DrOnkel/Rehab/README.md

# Rehab
The Post Stroke Spasticity Rehab Helper
