DrOnkel/Rehab/ReHabMath.pdf

ReHab Helper - Program comments and math

5-bar linkage
We use 5-bar linkage for 2D- movement. Two servo (7,8) rotate two lever arms (1,2), coupled with secondary lever arms by screw and nuts. Other ends of secondary lever arms coupled by screw and nuts too. In test system pointer is linked to this joint. The system of lever arms can rotate in all joints. The pointer can reach any point in area between two semicircles with radius= L1+L2 with centers in the middle of servo shafts. We connect servos to Arduino controller and

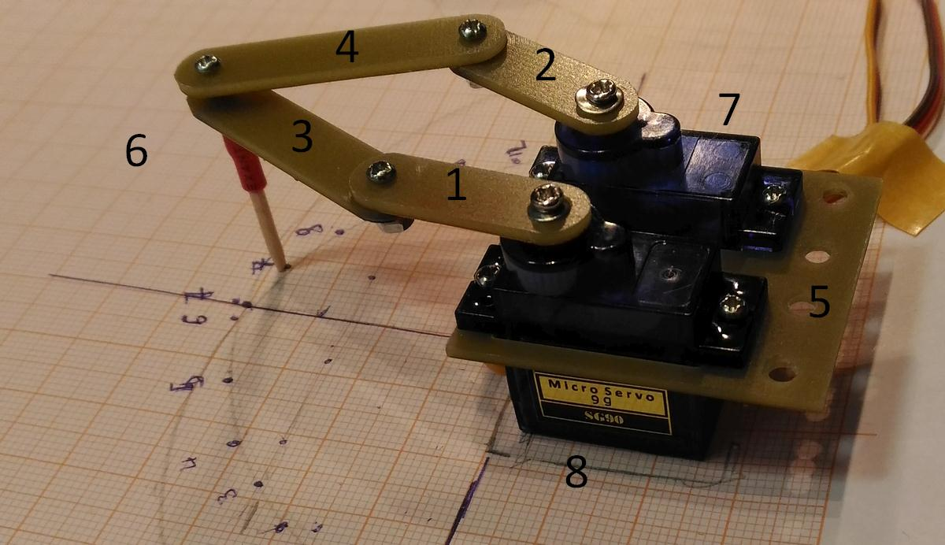
[picture p1: figure]

download ServoPot2Tester.ino program. We rotate potentiometers until the pointer is in the point we need. On monitor we can see the values of servo angles, we denote this angles as fi and psi.

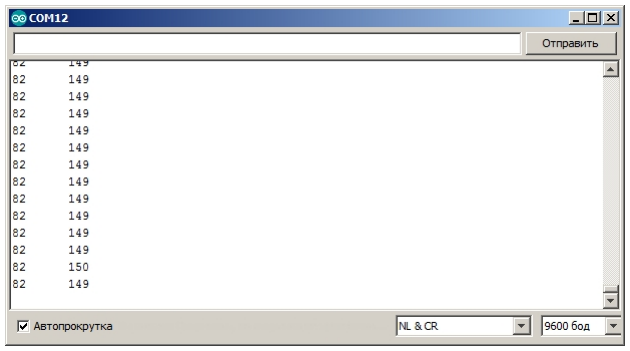
[picture p2: figure]

Write down the data for all 8 points of the path. You can insert the data in arrays of the program, in the array x (x=1,2,..7) Massx[8][2] in the order fi0, psi0, fi0, psi0 …. fi7, psi7 , and for the reverse array Massxr[8][2] in the order order fi7, psi7, fi6, psi6 …. Fi0, psi0 . You can insert data for any or all arrays instead of our default data. Modes 7 -16 are the same but with thumb movement. The Mode 17 is only thumb movement.

The program
Let us see the main parts of program. From the beginning.

You have to load LedControl library to you Arduino IDE program, please find it on http://playground.arduino.cc/Main/LedControl .

We use servo library from Arduino IDE program, the servo library is as a rule installed in core IDE.

Arduino controller calculate intermediate points within 8 points of the array. It makes the servo movement smooth and without jerks. The number of intermediate points can be from 3 to 35. The more the number the slowly moves the lever arms.

In the end of a program is a code for serial output of some data, it show the Mode , i and ns – number of point and of iteration within the points, Fi and Psi – angles of servo, Timer – time in milliseconds between the movements, Frames – quantity of iterations within the points, and Wipes- total wipes done.

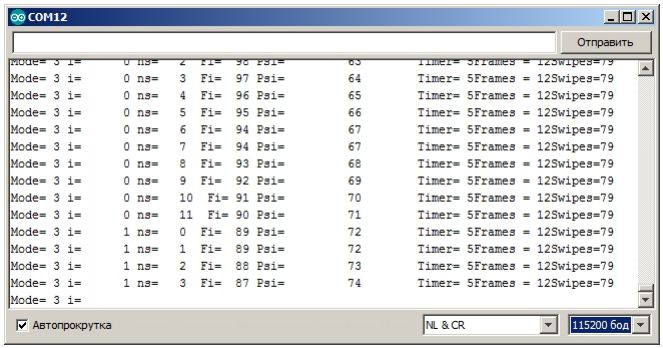
[picture p3: figure]
