DrOnkel/Rehab/RehabHelper03.JPG

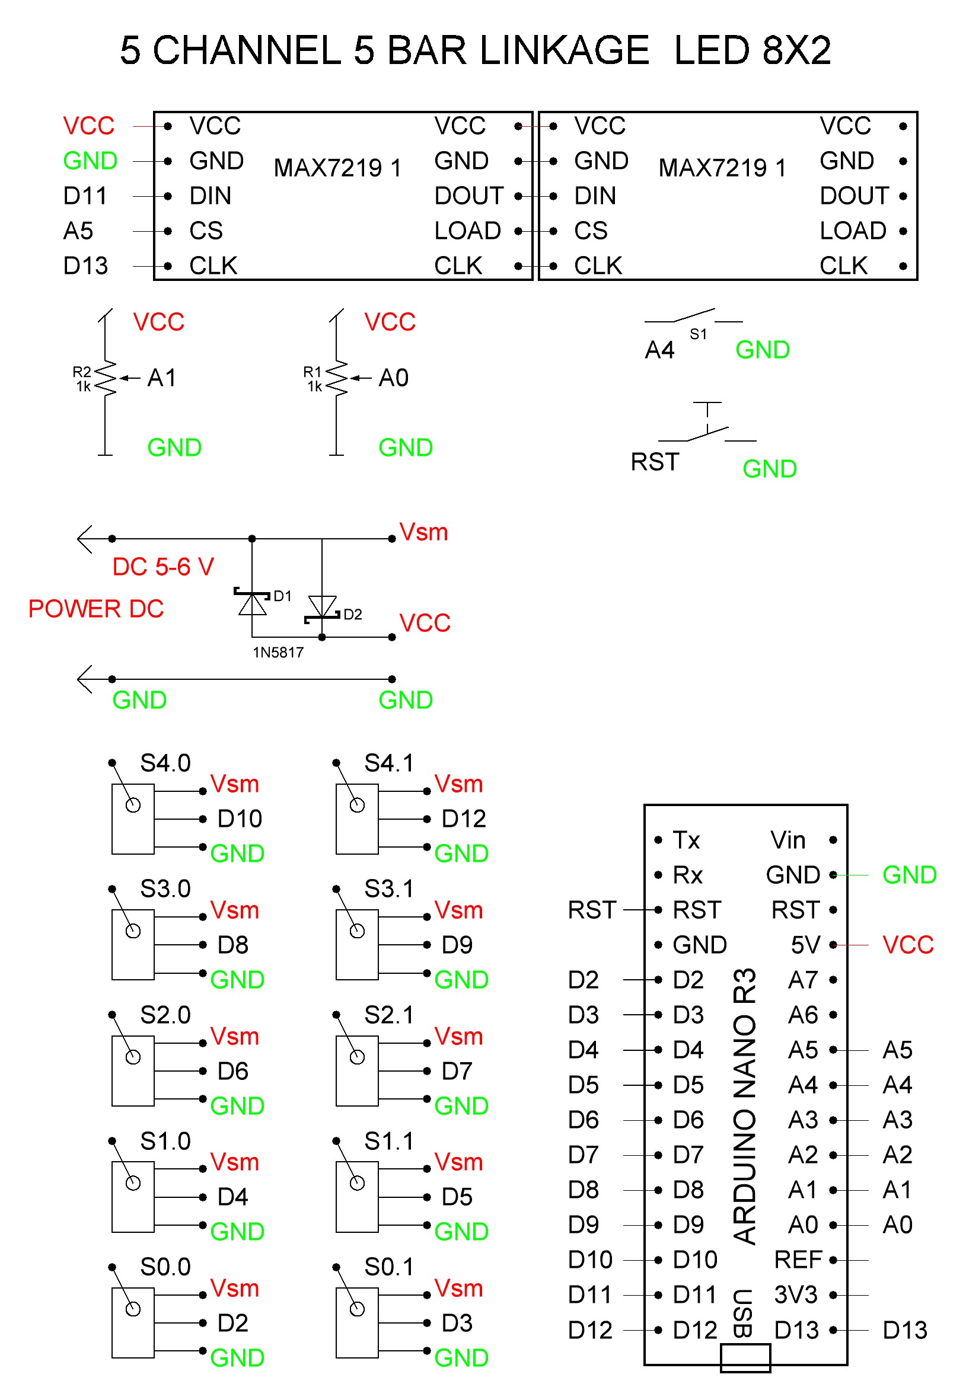
RehabHelper03.JPG
