DrOnkel/Rehab/RehabHelper04.JPG

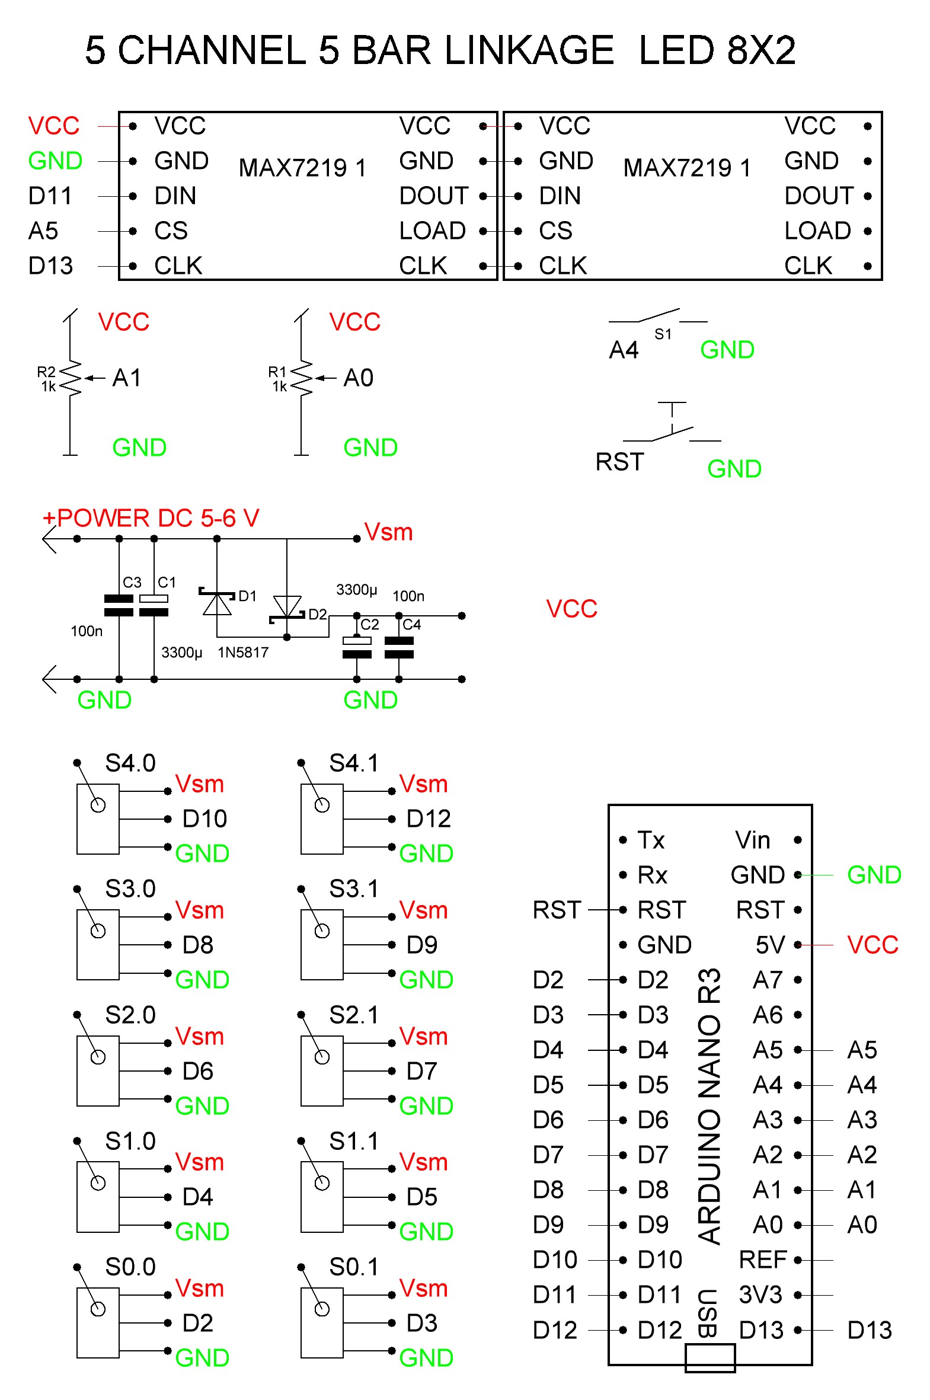
RehabHelper04.JPG
