DrOnkel/Rehab/(list of files, drawings)

Other design files:
RehabHelper04.spl7
